WojciechM98/DevKeyboard/src/power.kicad_sch

## KiCad design src/power.kicad_sch (2024-07-14)

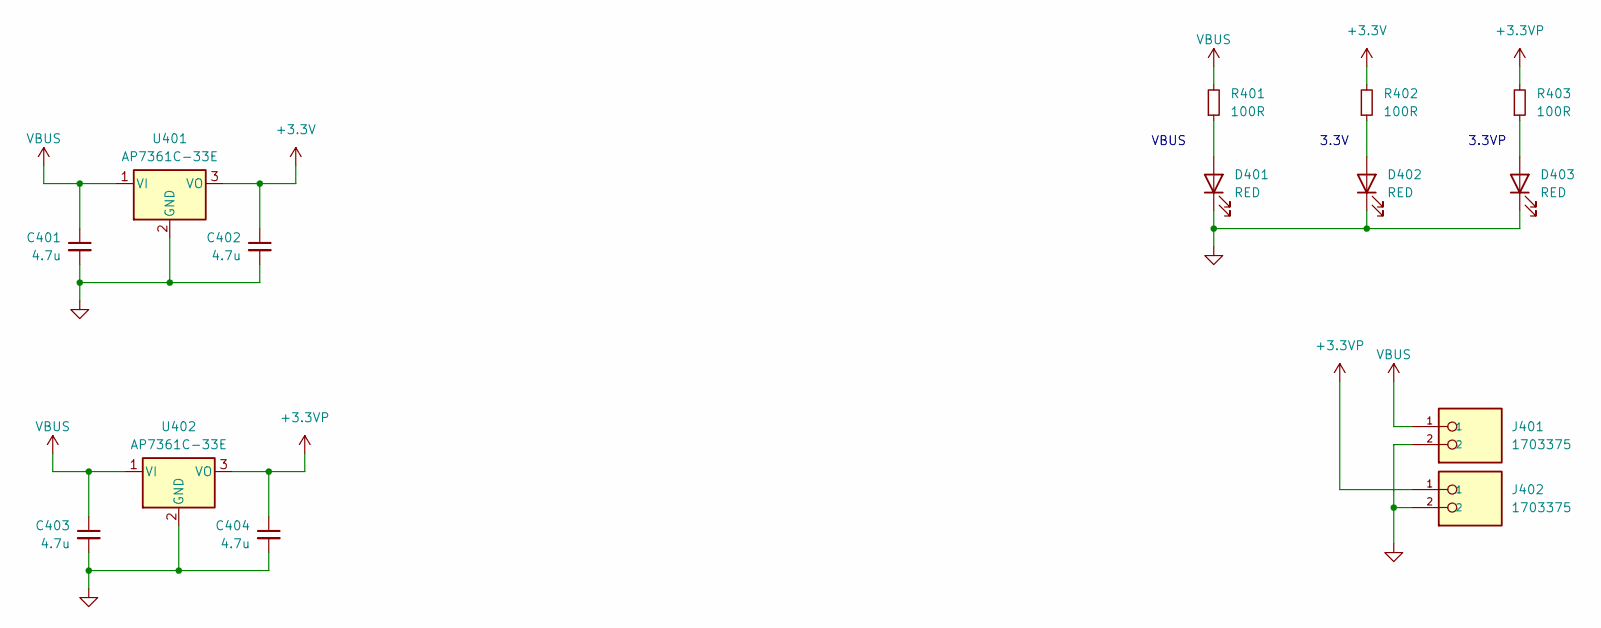
[picture p2: schematic power.kicad_sch]

Parts:
C401, C402, C403, C404: 4.7u; C_0603_1608Metric
D401, D402, D403: RED; LED_0603_1608Metric
J401, J402: 1703375; PHOENIX_1703375; PARTREV 01
R401, R402, R403: 100R; R_0402_1005Metric
U401, U402: AP7361C-33E; SOT-223

Connections:
+3.3V: C402.1, R402.2, U401.3 (VO)
+3.3VP: C404.1, J402.1, R403.2, U402.3 (VO)
GND: C401.2, C402.2, C403.2, C404.2, D401.1 (K), D402.1 (K), D403.1 (K), J401.2, J402.2, U401.2 (GND), U402.2 (GND)
unnamed: D401.2 (A), R401.1
unnamed: D402.2 (A), R402.1
unnamed: D403.2 (A), R403.1
VBUS: C401.1, C403.1, J401.1, R401.2, U401.1 (VI), U402.1 (VI)

Notes on the sheet:
3.3VP
VBUS
3.3V
