WojciechM98/DevKeyboard/src/processor.kicad_sch

## KiCad design src/processor.kicad_sch (2024-07-14)

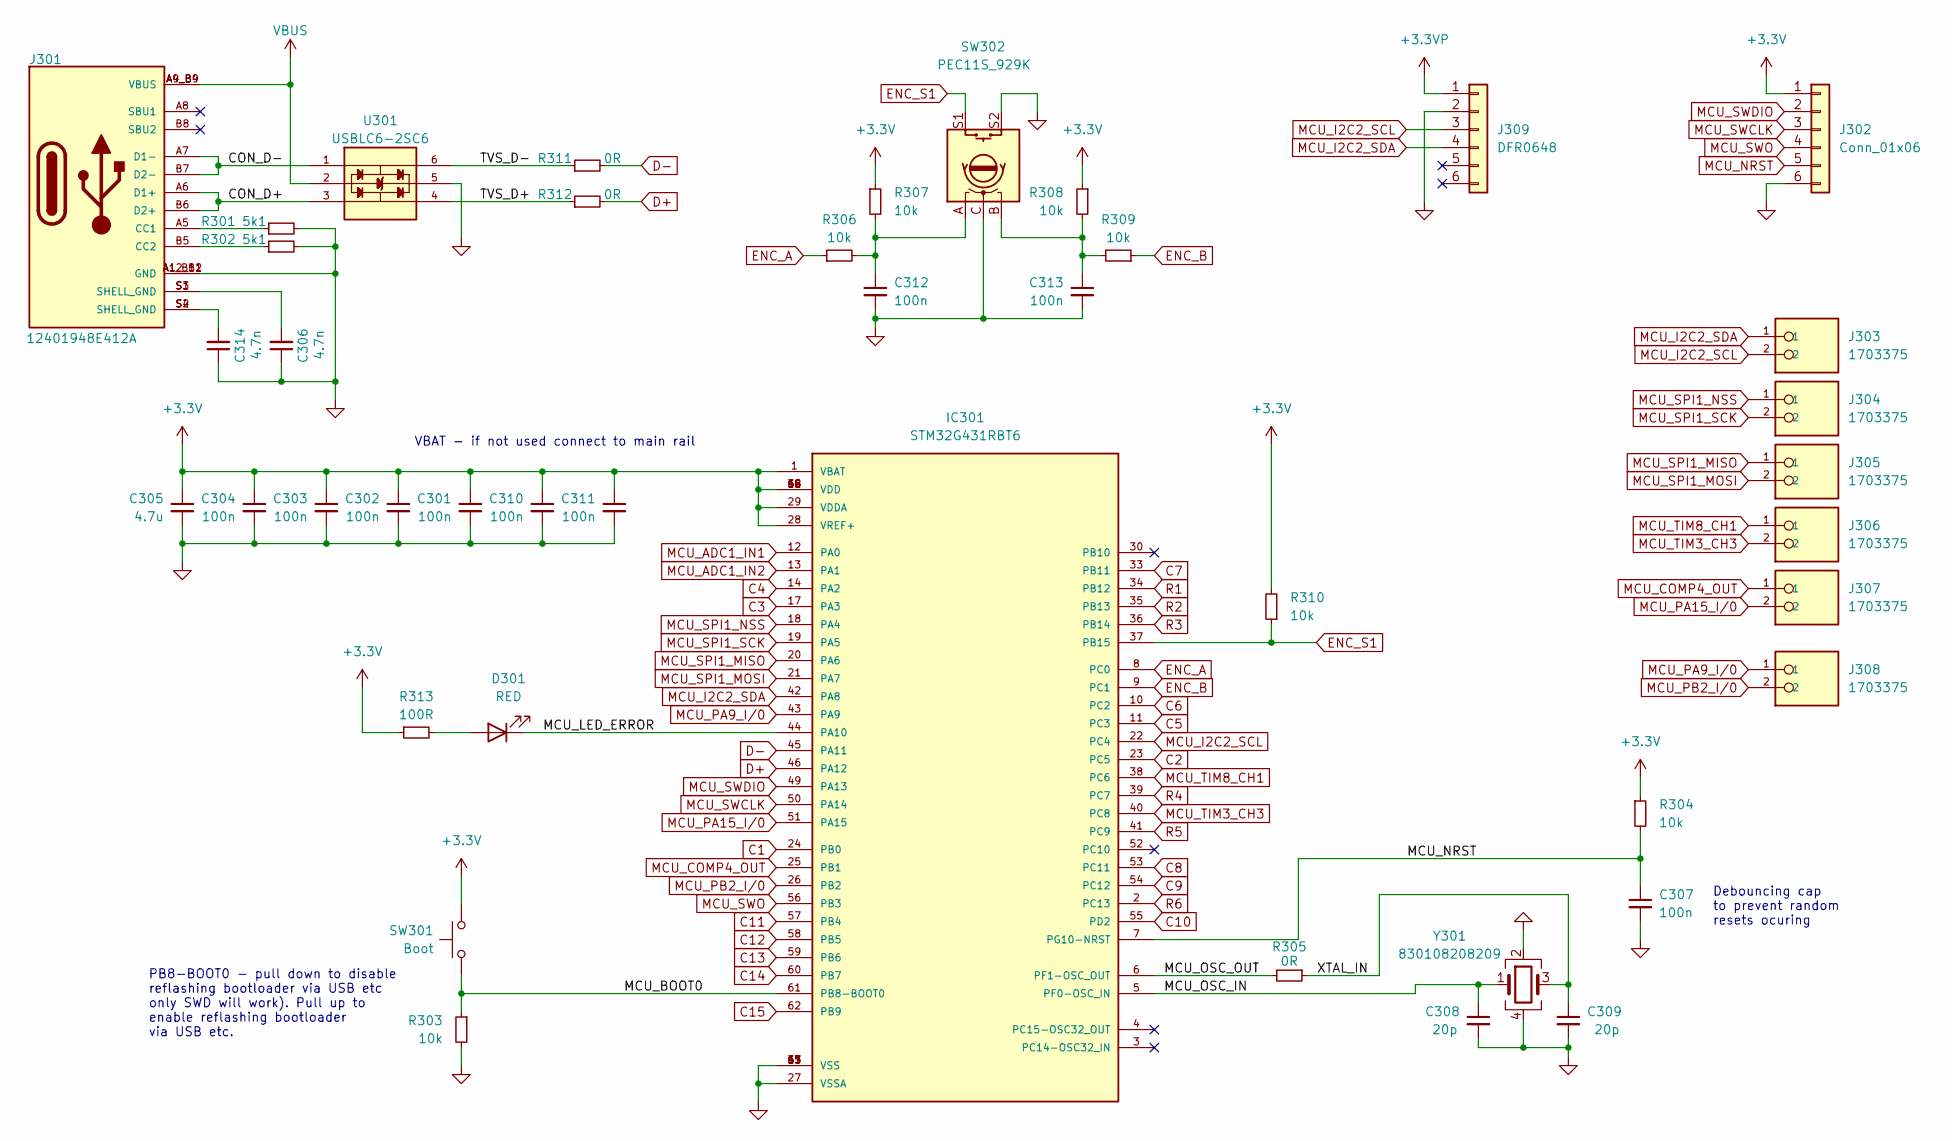
[picture p3: schematic processor.kicad_sch]

Parts:
C301, C302, C303, C304, C307, C310, C311, C312, C313: 100n; C_0402_1005Metric
C305: 4.7u; C_0603_1608Metric
C306, C314: 4.7n; C_0402_1005Metric
C308, C309: 20p; C_0402_1005Metric
D301: RED; LED_0603_1608Metric
IC301: STM32G431RBT6; QFP50P1200X1200X160-64N; Mouser_Part_Number 511-STM32G431RBT6
J301: 12401948E412A; AMPHENOL_12401948E412A; PARTREV 3
J302: Conn_01x06; A1001WV-S-6P
J303, J304, J305, J306, J307, J308: 1703375; PHOENIX_1703375; PARTREV 01
J309: DFR0648; A1001WV-S-6P
R301, R302: 5k1; R_0402_1005Metric
R303, R304, R306, R307, R308, R309, R310: 10k; R_0402_1005Metric
R305, R311, R312: 0R; R_0402_1005Metric
R313: 100R; R_0402_1005Metric
SW301: Boot; SW_Push_1P1T_NO_6x6mm_H9.5mm
SW302: PEC11S_929K; PEC11S-929K-S0015
U301: USBLC6-2SC6; SOT95P280X145-6N
Y301: 830108208209; Crystal_SMD_2520-4Pin_2.5x2.0mm

Connections:
+3.3V: C301.1, C302.1, C303.1, C304.1, C305.1, C310.1, C311.1, IC301.1 (VBAT), IC301.16 (VDD), IC301.28 (VREF+), IC301.29 (VDDA), IC301.32 (VDD), IC301.48 (VDD), IC301.64 (VDD), J302.1, R304.1, R307.1, R308.1, R310.2, R313.1, SW301.1
+3.3VP: J309.1
C1: IC301.24 (PB0)
C2: IC301.23 (PC5)
C3: IC301.17 (PA3)
C4: IC301.14 (PA2)
C5: IC301.11 (PC3)
C6: IC301.10 (PC2)
C7: IC301.33 (PB11)
C8: IC301.53 (PC11)
C9: IC301.54 (PC12)
C10: IC301.55 (PD2)
C11: IC301.57 (PB4)
C12: IC301.58 (PB5)
C13: IC301.59 (PB6)
C14: IC301.60 (PB7)
C15: IC301.62 (PB9)
CON_D+: J301.A6 (D1+), J301.B6 (D2+), U301.3
CON_D-: J301.A7 (D1-), J301.B7 (D2-), U301.1
D+: IC301.46 (PA12), R312.2
D-: IC301.45 (PA11), R311.2
ENC_A: IC301.8 (PC0), R306.1
ENC_B: IC301.9 (PC1), R309.1
ENC_S1: IC301.37 (PB15), R310.1, SW302.S1
GND: C301.2, C302.2, C303.2, C304.2, C305.2, C306.1, C307.2, C308.2, C309.2, C310.2, C311.2, C312.2, C313.2, C314.1, IC301.15 (VSS), IC301.27 (VSSA), IC301.31 (VSS), IC301.47 (VSS), IC301.63 (VSS), J301.A1_B12 (GND), J301.A12_B1 (GND), J302.6, J309.2, R301.2, R302.2, R303.2, SW302.C, SW302.S2, U301.5, Y301.2, Y301.4
MCU_ADC1_IN1: IC301.12 (PA0)
MCU_ADC1_IN2: IC301.13 (PA1)
MCU_BOOT0: IC301.61 (PB8-BOOT0), R303.1, SW301.2
MCU_COMP4_OUT: IC301.25 (PB1), J307.1
MCU_I2C2_SCL: IC301.22 (PC4), J303.2, J309.3
MCU_I2C2_SDA: IC301.42 (PA8), J303.1, J309.4
MCU_LED_ERROR: D301.1 (K), IC301.44 (PA10)
MCU_NRST: C307.1, IC301.7 (PG10-NRST), J302.5, R304.2
MCU_OSC_IN: C308.1, IC301.5 (PF0-OSC_IN), Y301.1
MCU_OSC_OUT: IC301.6 (PF1-OSC_OUT), R305.2
MCU_PA9_I/0: IC301.43 (PA9), J308.1
MCU_PA15_I/0: IC301.51 (PA15), J307.2
MCU_PB2_I/0: IC301.26 (PB2), J308.2
MCU_SPI1_MISO: IC301.20 (PA6), J305.1
MCU_SPI1_MOSI: IC301.21 (PA7), J305.2
MCU_SPI1_NSS: IC301.18 (PA4), J304.1
MCU_SPI1_SCK: IC301.19 (PA5), J304.2
MCU_SWCLK: IC301.50 (PA14), J302.3
MCU_SWDIO: IC301.49 (PA13), J302.2
MCU_SWO: IC301.56 (PB3), J302.4
MCU_TIM3_CH3: IC301.40 (PC8), J306.2
MCU_TIM8_CH1: IC301.38 (PC6), J306.1
unnamed: C306.2, J301.S1 (SHELL_GND), J301.S3 (SHELL_GND)
unnamed: C312.1, R306.2, R307.2, SW302.A
unnamed: C313.1, R308.2, R309.2, SW302.B
unnamed: C314.2, J301.S2 (SHELL_GND), J301.S4 (SHELL_GND)
unnamed: D301.2 (A), R313.2
unnamed: J301.A5 (CC1), R301.1
unnamed: J301.B5 (CC2), R302.1
R1: IC301.34 (PB12)
R2: IC301.35 (PB13)
R3: IC301.36 (PB14)
R4: IC301.39 (PC7)
R5: IC301.41 (PC9)
R6: IC301.2 (PC13)
TVS_D+: R312.1, U301.4
TVS_D-: R311.1, U301.6
VBUS: J301.A4_B9 (VBUS), J301.A9_B4 (VBUS), U301.2
XTAL_IN: C309.1, R305.1, Y301.3

Notes on the sheet:
Debouncing cap to prevent random resets ocuring
VBAT - if not used connect to main rail
PB8-BOOT0 - pull down to disable reflashing bootloader via USB etc only SWD will work). Pull up to enable reflashing bootloader via USB etc.
