WojciechM98/DevKeyboard/src/switches.kicad_sch

## KiCad design src/switches.kicad_sch (2024-07-14)

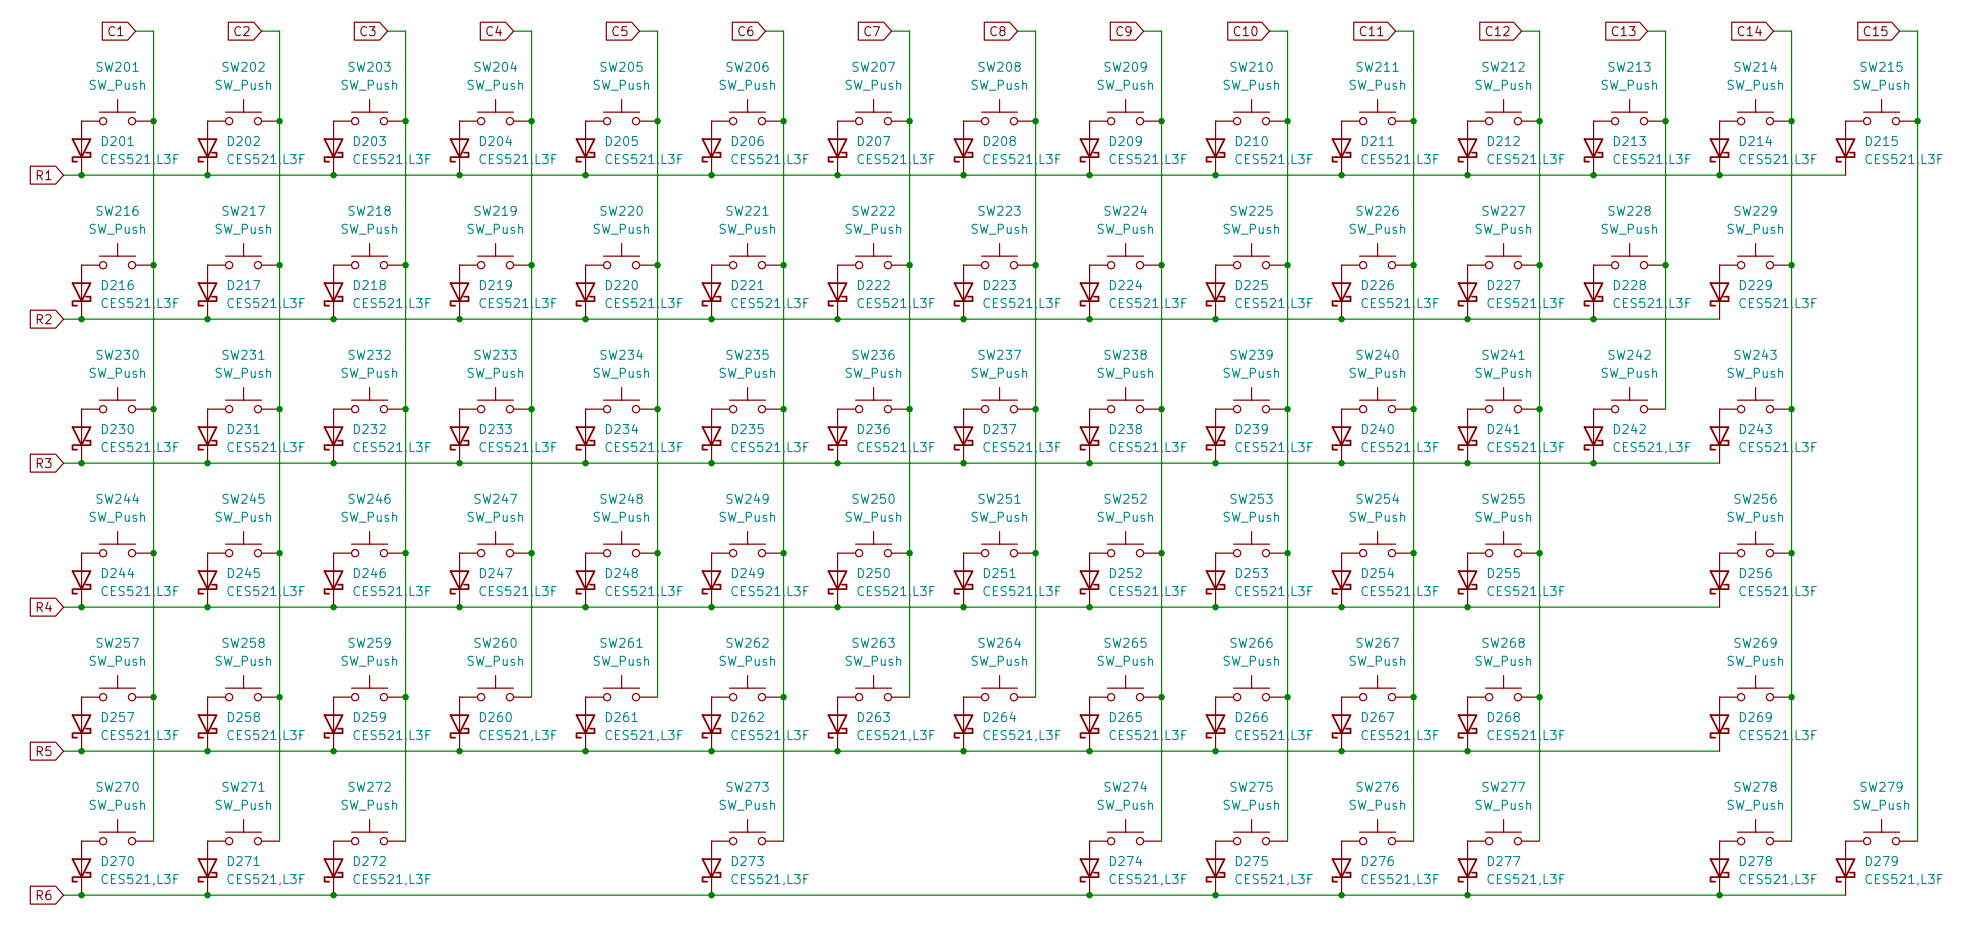
[picture p4: schematic switches.kicad_sch]

Parts:
D201, D202, D203, D204, D205, D206, D207, D208, D209, D210, D211, D212, D213, D214, D215, D216, D217, D218, D219, D220, D221, D222, D223, D224, D225, D226, D227, D228, D229, D230, D231, D232, D233, D234, D235, D236, D237, D238, D239, D240, D241, D242, D243, D244, D245, D246, D247, D248, D249, D250, D251, D252, D253, D254, D255, D256, D257, D258, D259, D260, D261, D262, D263, D264, D265, D266, D267, D268, D269, D270, D271, D272, D273, D274, D275, D276, D277, D278, D279: CES521,L3F; D_SOD-523
SW201, SW202, SW203, SW204, SW205, SW206, SW207, SW208, SW209, SW210, SW211, SW212, SW213, SW214, SW215, SW216, SW217, SW218, SW219, SW220, SW221, SW222, SW223, SW224, SW225, SW226, SW227, SW228, SW231, SW232, SW233, SW234, SW235, SW236, SW237, SW238, SW239, SW240, SW241, SW242, SW245, SW246, SW247, SW248, SW249, SW250, SW251, SW252, SW253, SW254, SW255, SW258, SW259, SW260, SW261, SW262, SW263, SW264, SW265, SW266, SW267, SW269, SW271, SW275, SW277, SW278, SW279: SW_Push; SW_Hotswap_Kailh_MX_1.00u
SW229: SW_Push; SW_Hotswap_Kailh_MX_2.00u
SW230, SW243: SW_Push; SW_Hotswap_Kailh_MX_1.50u
SW244, SW268: SW_Push; SW_Hotswap_Kailh_MX_1.75u
SW256, SW257: SW_Push; SW_Hotswap_Kailh_MX_2.25u
SW270, SW272, SW274, SW276: SW_Push; SW_Hotswap_Kailh_MX_1.25u
SW273: SW_Push; SW_Hotswap_Kailh_MX_6.00u

Connections:
C1: SW201.2, SW216.2, SW230.2, SW244.2, SW257.2, SW270.2
C2: SW202.2, SW217.2, SW231.2, SW245.2, SW258.2, SW271.2
C3: SW203.2, SW218.2, SW232.2, SW246.2, SW259.2, SW272.2
C4: SW204.2, SW219.2, SW233.2, SW247.2, SW260.2
C5: SW205.2, SW220.2, SW234.2, SW248.2, SW261.2
C6: SW206.2, SW221.2, SW235.2, SW249.2, SW262.2, SW273.2
C7: SW207.2, SW222.2, SW236.2, SW250.2, SW263.2
C8: SW208.2, SW223.2, SW237.2, SW251.2, SW264.2
C9: SW209.2, SW224.2, SW238.2, SW252.2, SW265.2, SW274.2
C10: SW210.2, SW225.2, SW239.2, SW253.2, SW266.2, SW275.2
C11: SW211.2, SW226.2, SW240.2, SW254.2, SW267.2, SW276.2
C12: SW212.2, SW227.2, SW241.2, SW255.2, SW268.2, SW277.2
C13: SW213.2, SW228.2, SW242.2
C14: SW214.2, SW229.2, SW243.2, SW256.2, SW269.2, SW278.2
C15: SW215.2, SW279.2
unnamed: D201.2 (A), SW201.1
unnamed: D202.2 (A), SW202.1
unnamed: D203.2 (A), SW203.1
unnamed: D204.2 (A), SW204.1
unnamed: D205.2 (A), SW205.1
unnamed: D206.2 (A), SW206.1
unnamed: D207.2 (A), SW207.1
unnamed: D208.2 (A), SW208.1
unnamed: D209.2 (A), SW209.1
unnamed: D210.2 (A), SW210.1
unnamed: D211.2 (A), SW211.1
unnamed: D212.2 (A), SW212.1
unnamed: D213.2 (A), SW213.1
unnamed: D214.2 (A), SW214.1
unnamed: D215.2 (A), SW215.1
unnamed: D216.2 (A), SW216.1
unnamed: D217.2 (A), SW217.1
unnamed: D218.2 (A), SW218.1
unnamed: D219.2 (A), SW219.1
unnamed: D220.2 (A), SW220.1
unnamed: D221.2 (A), SW221.1
unnamed: D222.2 (A), SW222.1
unnamed: D223.2 (A), SW223.1
unnamed: D224.2 (A), SW224.1
unnamed: D225.2 (A), SW225.1
unnamed: D226.2 (A), SW226.1
unnamed: D227.2 (A), SW227.1
unnamed: D228.2 (A), SW228.1
unnamed: D229.2 (A), SW229.1
unnamed: D230.2 (A), SW230.1
unnamed: D231.2 (A), SW231.1
unnamed: D232.2 (A), SW232.1
unnamed: D233.2 (A), SW233.1
unnamed: D234.2 (A), SW234.1
unnamed: D235.2 (A), SW235.1
unnamed: D236.2 (A), SW236.1
unnamed: D237.2 (A), SW237.1
unnamed: D238.2 (A), SW238.1
unnamed: D239.2 (A), SW239.1
unnamed: D240.2 (A), SW240.1
unnamed: D241.2 (A), SW241.1
unnamed: D242.2 (A), SW242.1
unnamed: D243.2 (A), SW243.1
unnamed: D244.2 (A), SW244.1
unnamed: D245.2 (A), SW245.1
unnamed: D246.2 (A), SW246.1
unnamed: D247.2 (A), SW247.1
unnamed: D248.2 (A), SW248.1
unnamed: D249.2 (A), SW249.1
unnamed: D250.2 (A), SW250.1
unnamed: D251.2 (A), SW251.1
unnamed: D252.2 (A), SW252.1
unnamed: D253.2 (A), SW253.1
unnamed: D254.2 (A), SW254.1
unnamed: D255.2 (A), SW255.1
unnamed: D256.2 (A), SW256.1
unnamed: D257.2 (A), SW257.1
unnamed: D258.2 (A), SW258.1
unnamed: D259.2 (A), SW259.1
unnamed: D260.2 (A), SW260.1
unnamed: D261.2 (A), SW261.1
unnamed: D262.2 (A), SW262.1
unnamed: D263.2 (A), SW263.1
unnamed: D264.2 (A), SW264.1
unnamed: D265.2 (A), SW265.1
unnamed: D266.2 (A), SW266.1
unnamed: D267.2 (A), SW267.1
unnamed: D268.2 (A), SW268.1
unnamed: D269.2 (A), SW269.1
unnamed: D270.2 (A), SW270.1
unnamed: D271.2 (A), SW271.1
unnamed: D272.2 (A), SW272.1
unnamed: D273.2 (A), SW273.1
unnamed: D274.2 (A), SW274.1
unnamed: D275.2 (A), SW275.1
unnamed: D276.2 (A), SW276.1
unnamed: D277.2 (A), SW277.1
unnamed: D278.2 (A), SW278.1
unnamed: D279.2 (A), SW279.1
R1: D201.1 (K), D202.1 (K), D203.1 (K), D204.1 (K), D205.1 (K), D206.1 (K), D207.1 (K), D208.1 (K), D209.1 (K), D210.1 (K), D211.1 (K), D212.1 (K), D213.1 (K), D214.1 (K), D215.1 (K)
R2: D216.1 (K), D217.1 (K), D218.1 (K), D219.1 (K), D220.1 (K), D221.1 (K), D222.1 (K), D223.1 (K), D224.1 (K), D225.1 (K), D226.1 (K), D227.1 (K), D228.1 (K), D229.1 (K)
R3: D230.1 (K), D231.1 (K), D232.1 (K), D233.1 (K), D234.1 (K), D235.1 (K), D236.1 (K), D237.1 (K), D238.1 (K), D239.1 (K), D240.1 (K), D241.1 (K), D242.1 (K), D243.1 (K)
R4: D244.1 (K), D245.1 (K), D246.1 (K), D247.1 (K), D248.1 (K), D249.1 (K), D250.1 (K), D251.1 (K), D252.1 (K), D253.1 (K), D254.1 (K), D255.1 (K), D256.1 (K)
R5: D257.1 (K), D258.1 (K), D259.1 (K), D260.1 (K), D261.1 (K), D262.1 (K), D263.1 (K), D264.1 (K), D265.1 (K), D266.1 (K), D267.1 (K), D268.1 (K), D269.1 (K)
R6: D270.1 (K), D271.1 (K), D272.1 (K), D273.1 (K), D274.1 (K), D275.1 (K), D276.1 (K), D277.1 (K), D278.1 (K), D279.1 (K)
